gmmg90/church/hardware/scheda-campane/docs/drc-report.txt

** Drc report for scheda-campane.kicad_pcb **
** Created on 2026-11-02 16:56:17 **

** Found 0 DRC violations **

** Found 0 unconnected pads **

** Found 0 Footprint errors **

** End of Report **
