gmmg90/church/hardware/scheda-campane/docs/scheda-lato-saldature.png

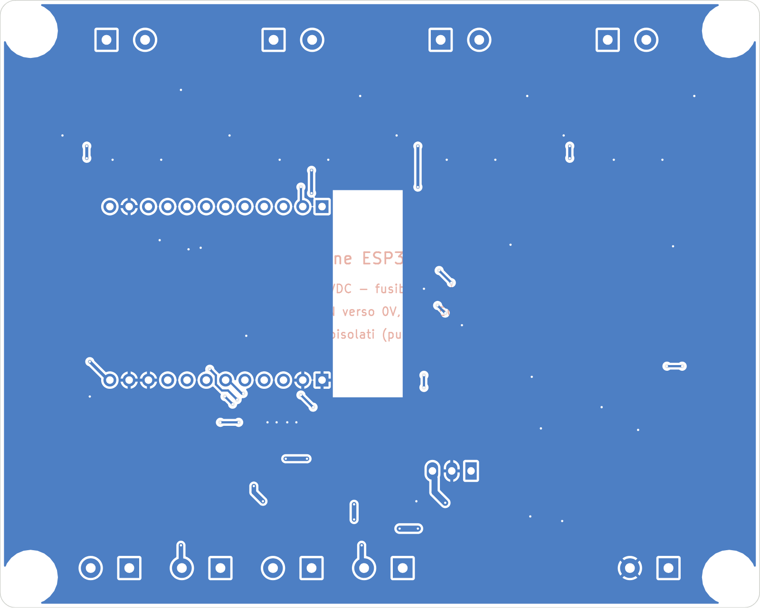
hardware/scheda-campane/docs/scheda-lato-saldature.png
