gmmg90/church/hardware/scheda-campane/docs/schema-elettrico.pdf

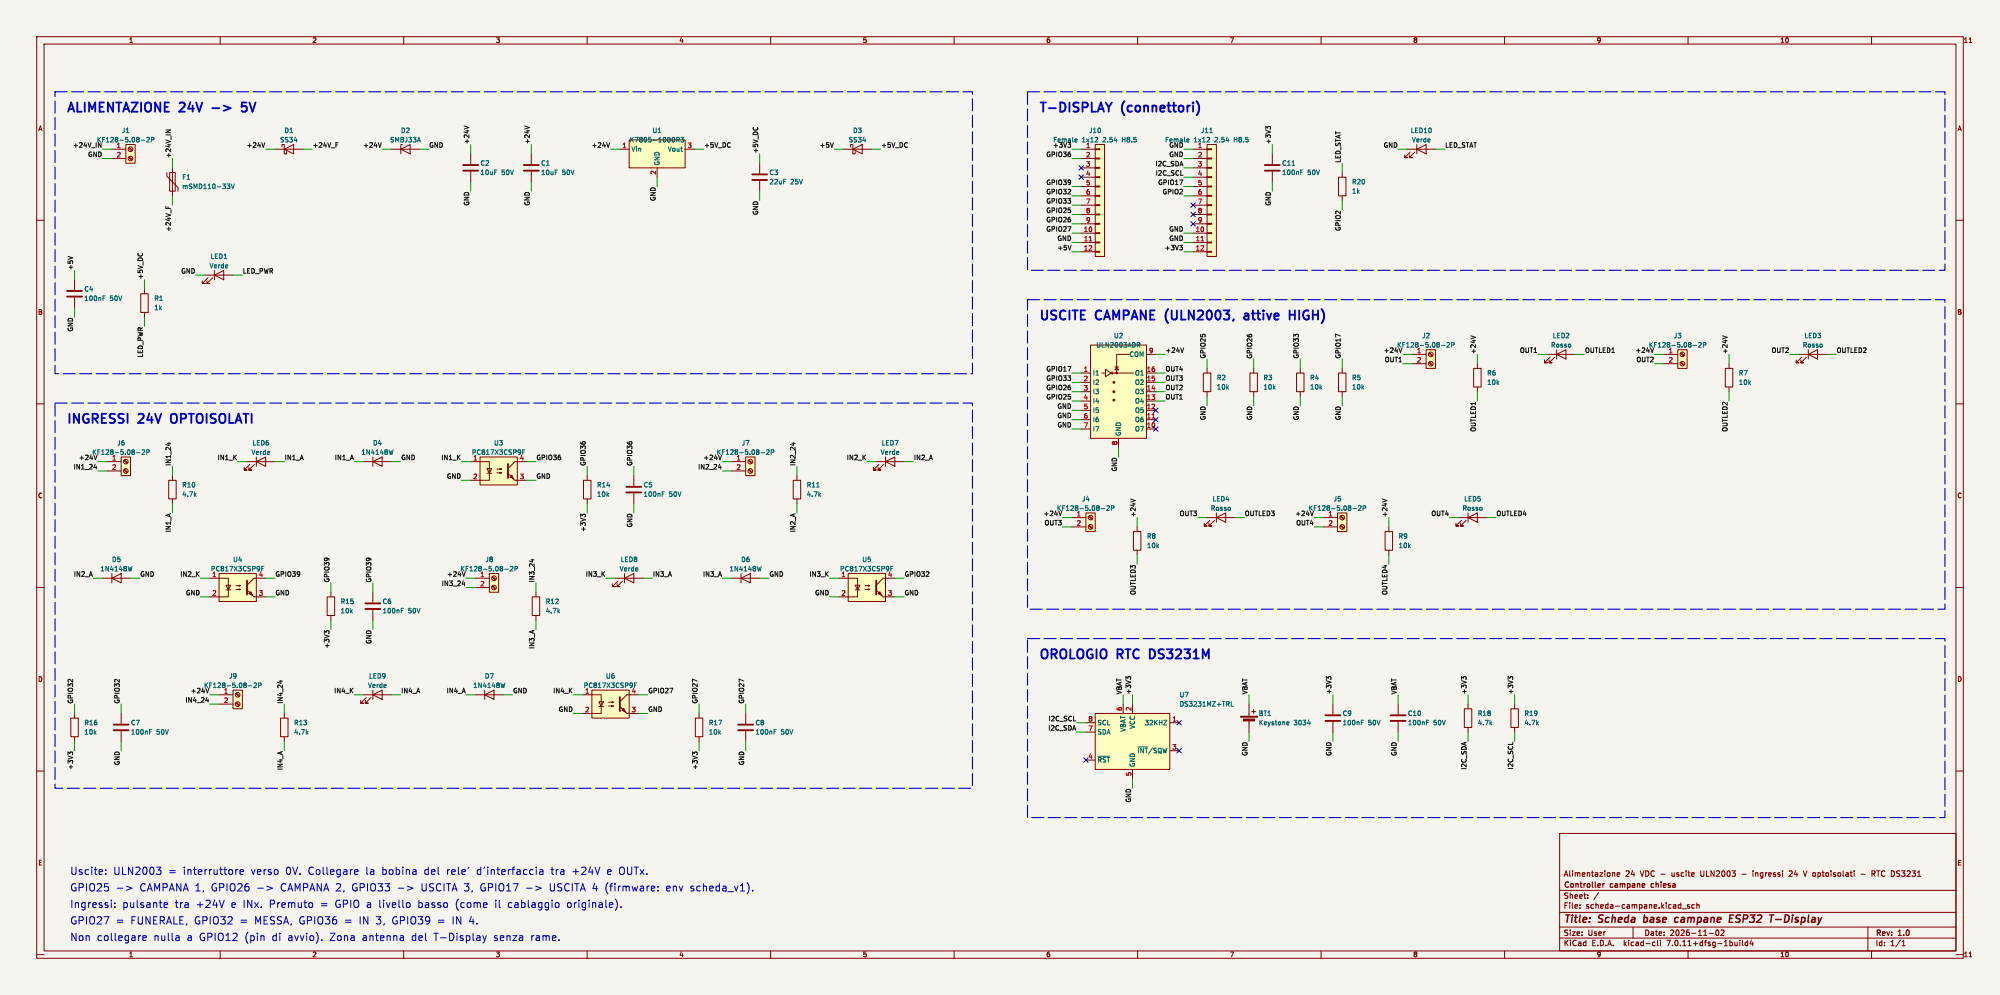
[picture p4: page 1]

GPIO27 = FUNERALE, GPIO32 = MESSA, GPIO36 = IN 3, GPIO39 = IN 4.

Id: 1/1 Title: Scheda base campane ESP32 T-Display
