gmmg90/church/hardware/scheda-campane/scheda-campane.kicad_pcb

## KiCad design hardware/scheda-campane/scheda-campane.kicad_pcb (2026-11-02)

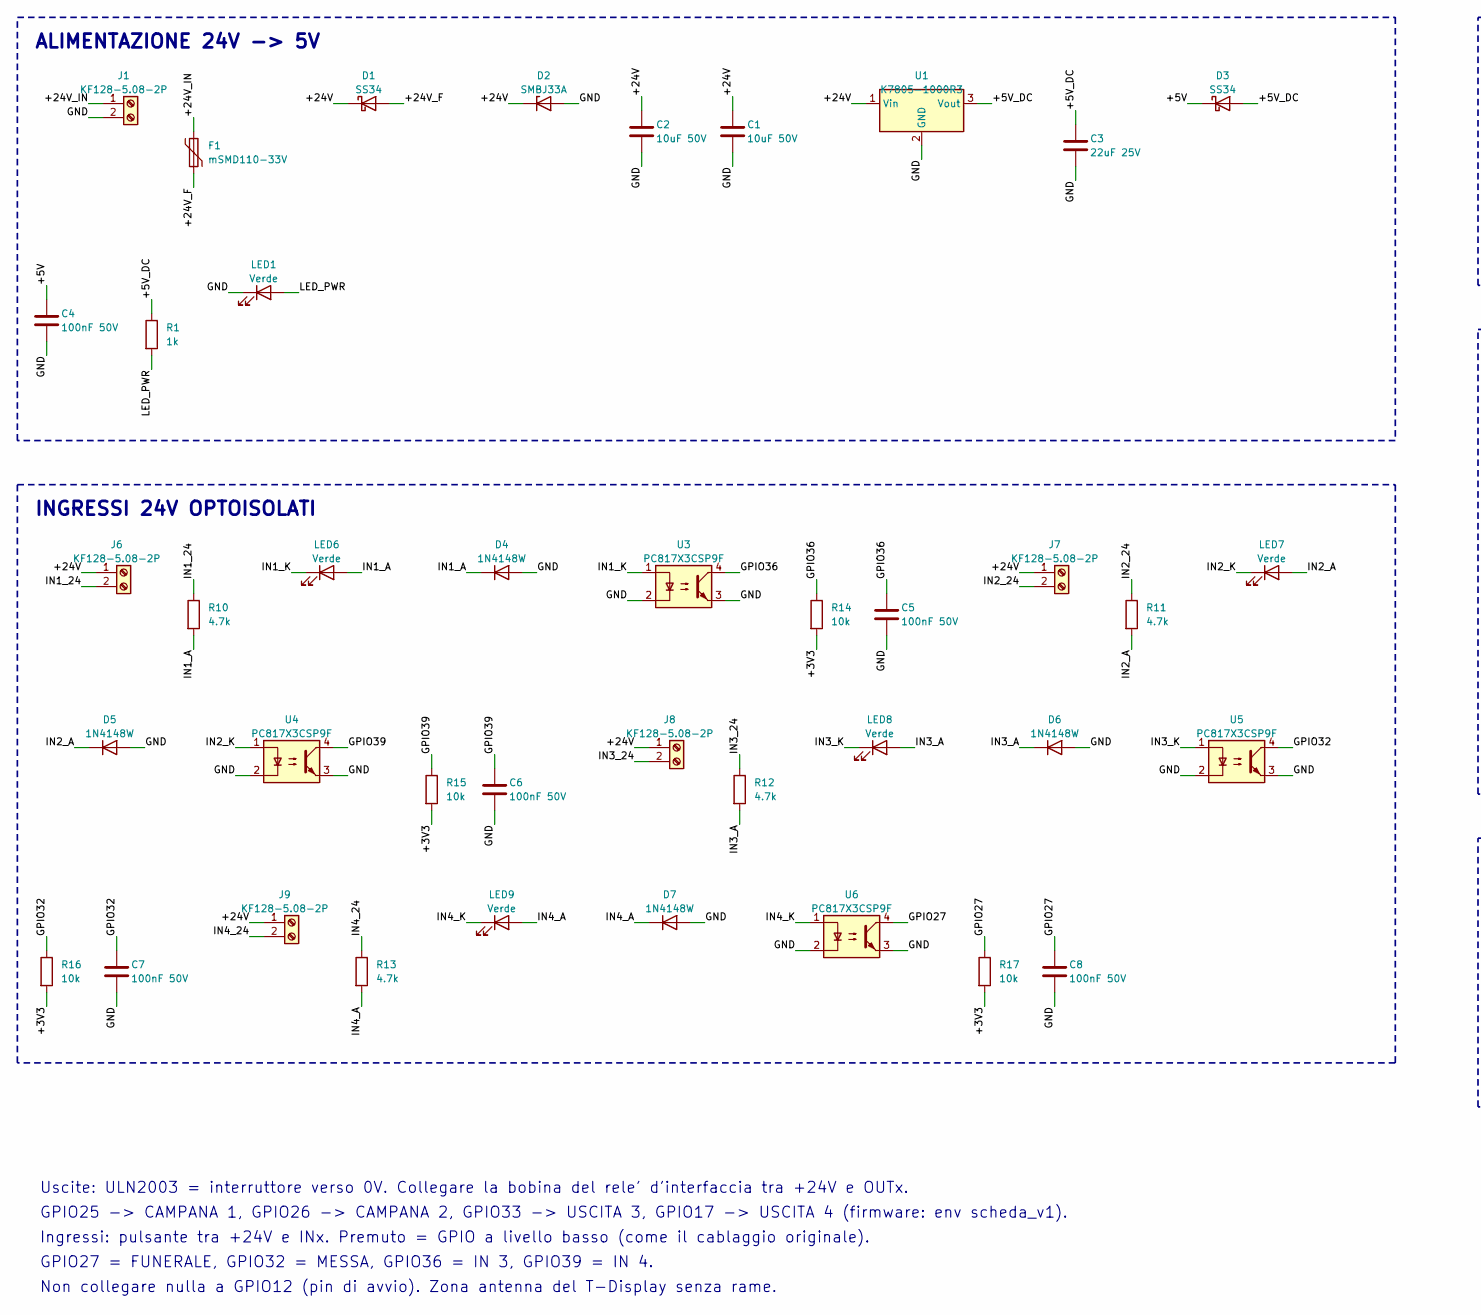
[picture p5: schematic scheda-campane.kicad_sch, Scheda base campane ESP32 T-Display, part in row 1, column 1]

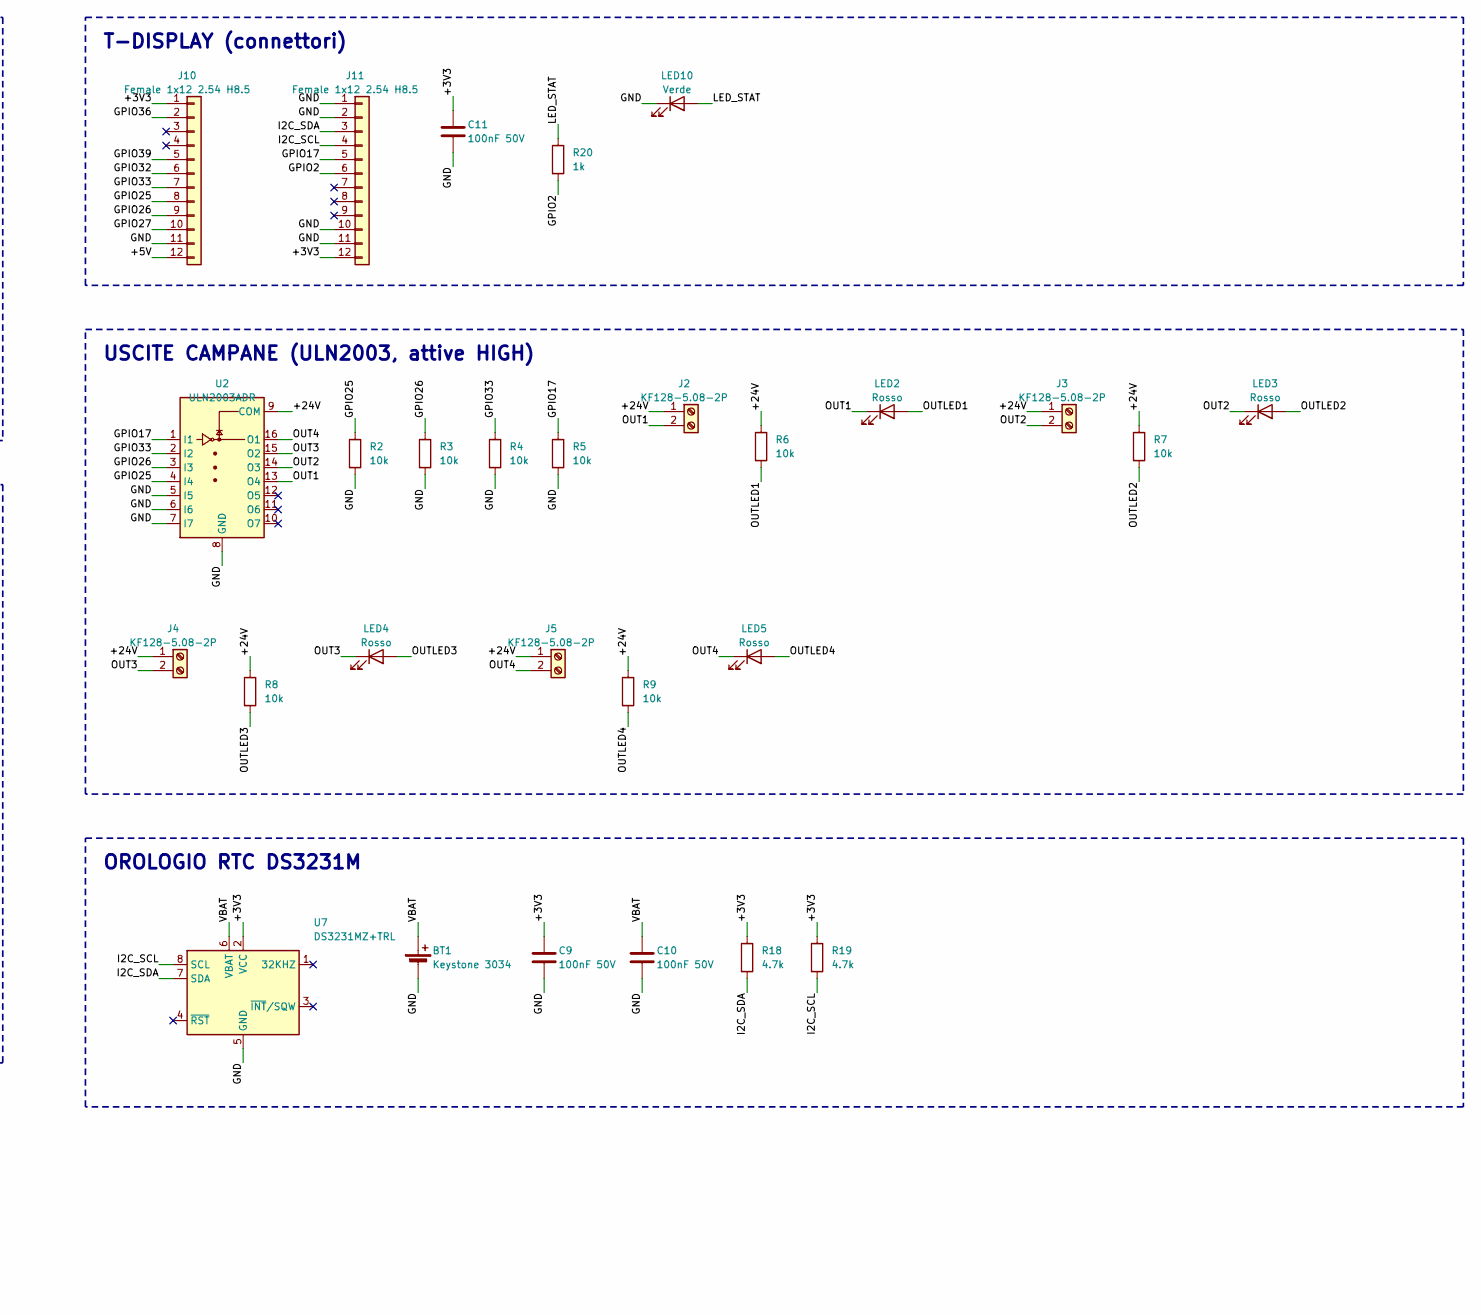
[picture p6: schematic scheda-campane.kicad_sch, Scheda base campane ESP32 T-Display, part in row 1, column 2]

Parts:
BT1: Keystone 3034; BatteryHolder_Keystone_3034_1x20mm; LCSC C5213768
C1, C2: 10uF 50V; C_1206_3216Metric; LCSC C13585
C3: 22uF 25V; C_0805_2012Metric; LCSC C45783
C4, C5, C6, C7, C8, C9, C10, C11: 100nF 50V; C_0603_1608Metric; LCSC C14663
D1, D3: SS34; D_SMA; LCSC C8678
D2: SMBJ33A; D_SMB; LCSC C224019
D4, D5, D6, D7: 1N4148W; D_SOD-123; LCSC C81598
F1: mSMD110-33V; Fuse_1812_4532Metric; LCSC C70119
J1, J2, J3, J4, J5, J6, J7, J8, J9: KF128-5.08-2P; TerminalBlock_Phoenix_MKDS-1,5-2-5.08_1x02_P5.08mm_Horizont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; LCSC C474952
J10, J11: Female 1x12 2.54 H8.5; PinSocket_1x12_P2.54mm_Vertical; LCSC C22373898
LED1, LED6, LED7, LED8, LED9, LED10: Verde; LED_0805_2012Metric; LCSC C2297
LED2, LED3, LED4, LED5: Rosso; LED_0603_1608Metric; LCSC C2286
R1, R20: 1k; R_0603_1608Metric; LCSC C21190
R2, R3, R4, R5, R14, R15, R16, R17: 10k; R_0603_1608Metric; LCSC C25804
R6, R7, R8, R9: 10k; R_0805_2012Metric; LCSC C17414
R10, R11, R12, R13: 4.7k; R_1206_3216Metric; LCSC C17936
R18, R19: 4.7k; R_0603_1608Metric; LCSC C23162
U1: K7805-1000R3; Converter_DCDC_RECOM_R-78E-0.5_THT; LCSC C2992391
U2: ULN2003ADR; SOIC-16_3.9x9.9mm_P1.27mm; LCSC C7512
U3, U4, U5, U6: PC817X3CSP9F; SMDIP-4_W9.53mm; LCSC C41807
U7: DS3231MZ+TRL; SOIC-8_3.9x4.9mm_P1.27mm; LCSC C107410

Connections:
+3V3: C9.1, C11.1, J10.1, J11.12, R14.2, R15.2, R16.2, R17.2, R18.1, R19.1, U7.2 (VCC)
+5V: C4.1, D3.1 (K), J10.12
+5V_DC: C3.1, D3.2 (A), R1.1, U1.3 (Vout)
+24V: C1.1, C2.1, D1.1 (K), D2.1 (K), J2.1, J3.1, J4.1, J5.1, J6.1, J7.1, J8.1, J9.1, R6.1, R7.1, R8.1, R9.1, U1.1 (Vin), U2.9 (COM)
+24V_F: D1.2 (A), F1.2
+24V_IN: F1.1, J1.1
GND: BT1.2 (-), C1.2, C2.2, C3.2, C4.2, C5.2, C6.2, C7.2, C8.2, C9.2, C10.2, C11.2, D2.2 (A), D4.2 (A), D5.2 (A), D6.2 (A), D7.2 (A), J1.2, J10.11, J11.1, J11.2, J11.10, J11.11, LED1.1 (K), LED10.1 (K), R2.2, R3.2, R4.2, R5.2, U1.2 (GND), U2.5 (I5), U2.6 (I6), U2.7 (I7), U2.8 (GND), U3.2, U3.3, U4.2, U4.3, U5.2, U5.3, U6.2, U6.3, U7.5 (GND)
GPIO2: J11.6, R20.2
GPIO17: J11.5, R5.1, U2.1 (I1)
GPIO25: J10.8, R2.1, U2.4 (I4)
GPIO26: J10.9, R3.1, U2.3 (I3)
GPIO27: C8.1, J10.10, R17.1, U6.4
GPIO32: C7.1, J10.6, R16.1, U5.4
GPIO33: J10.7, R4.1, U2.2 (I2)
GPIO36: C5.1, J10.2, R14.1, U3.4
GPIO39: C6.1, J10.5, R15.1, U4.4
I2C_SCL: J11.4, R19.2, U7.8 (SCL)
I2C_SDA: J11.3, R18.2, U7.7 (SDA)
IN1_24: J6.2, R10.1
IN1_A: D4.1 (K), LED6.2 (A), R10.2
IN1_K: LED6.1 (K), U3.1
IN2_24: J7.2, R11.1
IN2_A: D5.1 (K), LED7.2 (A), R11.2
IN2_K: LED7.1 (K), U4.1
IN3_24: J8.2, R12.1
IN3_A: D6.1 (K), LED8.2 (A), R12.2
IN3_K: LED8.1 (K), U5.1
IN4_24: J9.2, R13.1
IN4_A: D7.1 (K), LED9.2 (A), R13.2
IN4_K: LED9.1 (K), U6.1
LED_PWR: LED1.2 (A), R1.2
LED_STAT: LED10.2 (A), R20.1
OUT1: J2.2, LED2.1 (K), U2.13 (O4)
OUT2: J3.2, LED3.1 (K), U2.14 (O3)
OUT3: J4.2, LED4.1 (K), U2.15 (O2)
OUT4: J5.2, LED5.1 (K), U2.16 (O1)
OUTLED1: LED2.2 (A), R6.2
OUTLED2: LED3.2 (A), R7.2
OUTLED3: LED4.2 (A), R8.2
OUTLED4: LED5.2 (A), R9.2
VBAT: BT1.1 (+), C10.1, U7.6 (VBAT)

Notes on the sheet:
ALIMENTAZIONE 24V -> 5V
INGRESSI 24V OPTOISOLATI
T-DISPLAY (connettori)
USCITE CAMPANE (ULN2003, attive HIGH)
OROLOGIO RTC DS3231M
Uscite: ULN2003 = interruttore verso 0V. Collegare la bobina del rele' d'interfaccia tra +24V e OUTx.
GPIO25 -> CAMPANA 1, GPIO26 -> CAMPANA 2, GPIO33 -> USCITA 3, GPIO17 -> USCITA 4 (firmware: env scheda_v1).
Ingressi: pulsante tra +24V e INx. Premuto = GPIO a livello basso (come il cablaggio originale).
GPIO27 = FUNERALE, GPIO32 = MESSA, GPIO36 = IN 3, GPIO39 = IN 4.
Non collegare nulla a GPIO12 (pin di avvio). Zona antenna del T-Display senza rame.

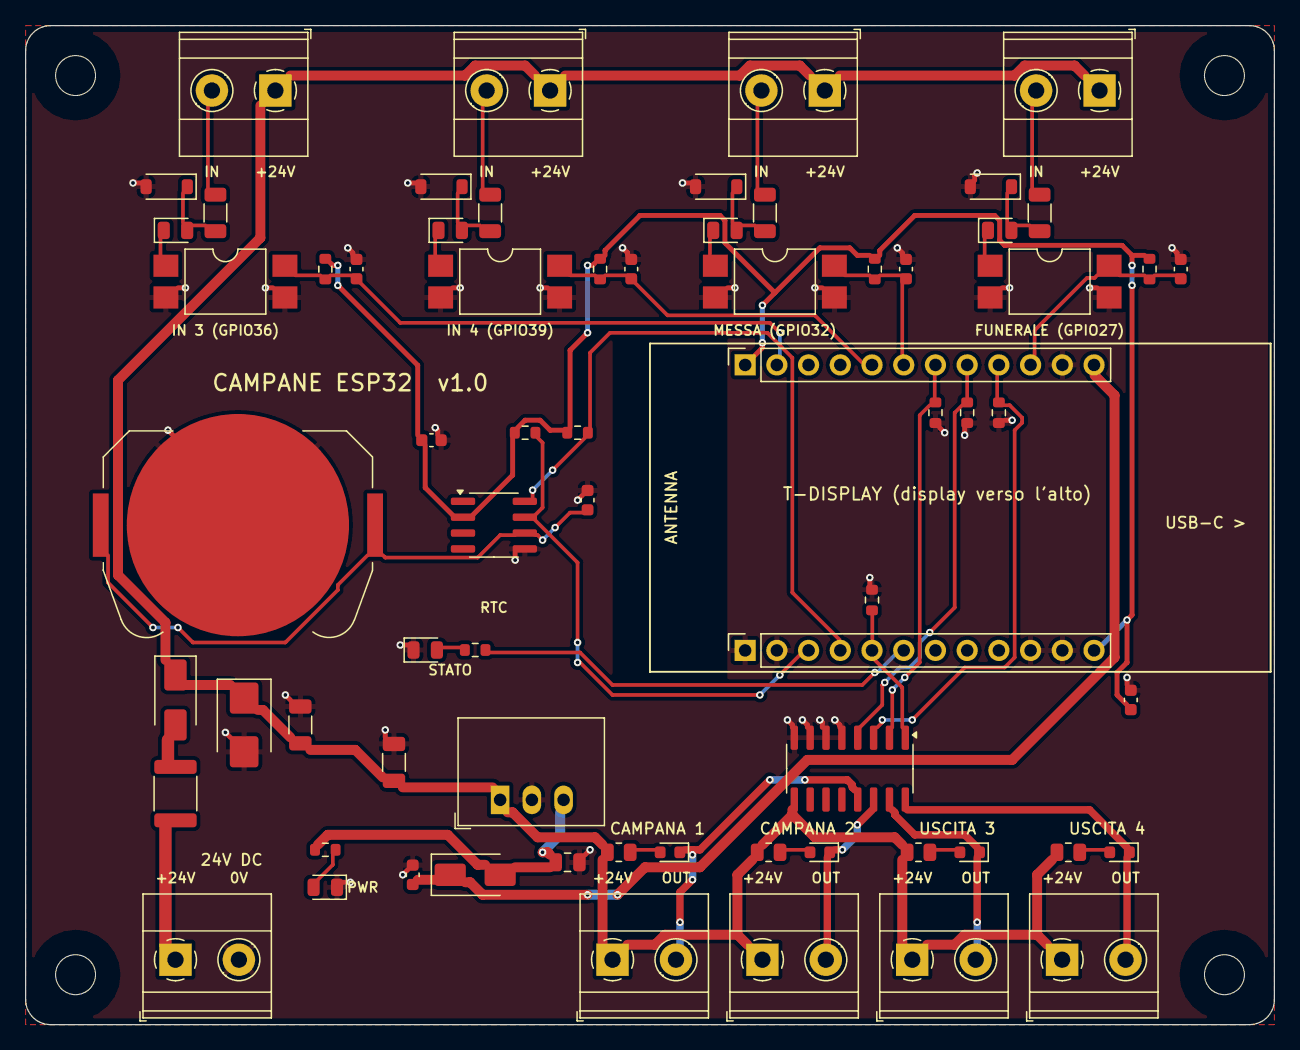
[picture p7: board scheda-campane.kicad_pcb from above]

Board: 2 copper layers, 100.0 x 80.0 mm, 72 parts (0 on the bottom side), 41 nets.

Other parts of the board:
MH1, MH2, MH3, MH4: M3; MountingHole_3.2mm_M3
