gmmg90/church/(commit log)

2026-11-02 Aggiunge scheda base campane v1.0 (Gerber JLCPCB) e uscite configurabili
    Nuova scheda 100x80 mm per T-Display ESP32 in hardware/scheda-campane:
    - alimentazione 24 VDC con fusibile ripristinabile, protezione inversione
    polarità, TVS e convertitore TRACO 24V->5V
    - 4 uscite 24V tramite ULN2003 (spente a ESP32 spento/in reset), con LED
    - 4 ingressi 24V optoisolati (FUNERALE, MESSA, 2 riserve), con LED
    - RTC DS3231 integrato con batteria CR2032
    - zoccolo per il T-Display, USB-C sul bordo, zona antenna senza rame
    - Gerber, BOM e CPL pronti per JLCPCB (codici LCSC verificati),
    progetto KiCad, schema elettrico PDF, DRC senza errori
    - script per rigenerare tutto (posizionamento, piste, export, s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
2026-11-02 Scheda campane: componenti più economici (circa -50% sul costo BOM)
    - RTC: DS3231SN (9 $) -> DS3231MZ+ SOIC-8 (3,35 $), stessi registri,
    firmware invariato
    - DC-DC: TRACO TSR 1-2450 (6,5 $) -> K7805-1000R3 YLPTEC (2,36 $),
    stessa piedinatura e ingombro, ingresso 8-36 V
    - C1: elettrolitico 100 uF (Extended) -> ceramico 10 uF 50 V (Basic)
    - LED verdi: KT-0603G (Extended) -> KT-0805G (Basic)
    - correzione automatica delle connessioni termiche incomplete al piano GND
    - README: stima costi e suggerimenti per risparmiare
    Costo componenti per 5 schede: da circa 98 $ a 48 $; tipi Extended da 10 a 8.
    DRC: 0 errori, schema e PCB con reti identiche.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
